jks0502/mcwave/enclosure/README.md

# 富哥方案 · 桌面外壳 V3

按用户确认，将转接板放在屏幕背后现有空间，取消 V2 的独立后仓。总深度由约 77.75 缩至 68.25 mm，减少 9.5 mm。a∥d、后倾12°、左侧29×14mm充电缺口保留。

## 打印文件

print-package-v3.zip 包含以下三个 STL 和打印说明.txt。每件一份，单位 mm，1:1，不缩放。

| 文件 | 零件 | 打印姿态外形 mm |
|---|---|---|
| front.stl | 前框 | 105 × 90.5 × 2.4 |
| body.stl | 后壳底座 | 105 × 65.9 × 94.52 |
| lid.stl | 可拆底盖、限位条 | 99.6 × 56.9 × 9 |

装配外形约105×68.25×95.02mm（宽×深×高）。使用V3整套文件，底座和底盖不可混用V2。
前框和底盖平放，后壳底口朝下需可拆支撑；从底口清理。材料、层高、支撑、首层补偿请商家按设备确定。所有屏座与排线通道去毛刺。

## 本次修改

- 转接板的容量参考为沿屏面的36×30mm、厚4mm，随屏幕倾斜放在屏背空间。该值是设计容量，尚无转接板实测尺寸。
- 屏幕前框和玻璃定位沿用V2；前框STL与V2几何相同。
- 组件 d=97沿左右，e=34沿前后，f=38竖直；相对V2后移2mm，为屏背薄板留余量。
- 组件下方3mm安装高度、平顶净空约2.8mm保留。
- 取消转接板后仓，组件后侧仅留7.5mm用于螺丝柱及装配。后螺丝柱外径6mm，后限位条避让螺丝柱。
- 充电缺口随组件位置平移，仍在左侧且沿e的中央，沿前后宽29mm，从外部底边向上14mm。插头伸入内部时要考虑3mm底盖占用。
- 转接板和屏幕、驱动板之间分两段预留走线，实际线长、插头方向和柔性排线的弯曲仍需试装。

## 装配

1. 清理支撑、毛刺，先不装前框和底盖。
2. 屏幕玻璃91×76.5mm从前面放进后壳浅座，FPC穿下方通道。用户屏厚估计0.95～1.0mm，模型检查按1.2mm参考。薄软垫仅放在非显示边缘，按实际厚度调整，不硬夹玻璃。
3. 四颗3×8mm盘头塑料自攻螺丝轻锁前框。
4. 蓝色转接板随屏面倾斜布置在屏背空余区域，采用绝缘软垫/胶固定在后壳内表面，不让它顶压玻璃。连接屏幕FPC，留出接口和排线余量。
5. 电池、电源和驱动板保持现有组合，在底盖上横放，97mm长边平行屏幕宽边，充电口朝左。用绝缘软垫在可靠支撑面固定，3mm为预留安装高度，避开PCB元件焊点。
6. 延长线由转接板通往组件，按内部空隙自然弯曲收纳。装底盖前用实际Type-C线试插开口，确认板件和线缆均不受挤压。
7. 底盖及组件从下方放入，四颗3×10mm沉头塑料自攻螺丝固定。底孔2.5mm、通孔3.4mm，打印商家需确认螺丝适配。
8. 可贴8mm脚垫四个。底盖用于装配和检修，无独立电池仓盖；检修前断电并释放排线余量。

## CAD 与验证

desktop-enclosure-v3.FCStd 为三个独立实体，装配姿态。尺寸修改使用 design-parameters.json 和 build_case.py 重新生成，Dimensions表仅为尺寸记录。
cad-preview.png 从实际CAD网格渲染，棕色为屏背转接板容量、绿色为组件包络、蓝色为两段走线预留。

已通过深层BOP自交、单一有效实体、零件及参考玻璃/组件无碰撞、屏背转接容量无碰撞、两段走线空隙、玻璃前装、组件/底盖底装、玻璃边缘限位、a∥d实际包络方向、左侧缺口，以及STL封闭和重新导入尺寸体积检查。结果见 verification.json。

尚未打印试装。真实转接板与线缆未测量，屏厚不准确，打印误差与充电插头净空也需实物验证。
