jks0502/mcwave/enclosure/打印说明.txt

富哥方案桌面外壳 V3 - 屏背转接板紧凑版
转接板放屏幕后，取消独立后仓；a与d平行，Type-C仍在左侧。
装配约105 x68.25 x95.02mm。使用V3整套三个STL，底座底盖不要混用V2。
单位mm，1:1，禁止自动缩放。三个零件各打印一件：
front.stl：前框105 x90.5 x2.4mm，平放。
body.stl：后壳底座105 x65.9 x94.52mm，需可拆支撑，从底口清理。
lid.stl：底盖99.6 x56.9 x9mm，底面朝下。
STL已分别放在Z=0。
材料、层高、支撑和首层补偿按商家设备确定；底盖每侧装配间隙0.3mm。
屏座、孔和排线通道去毛刺，玻璃只在非显示边缘软垫支撑，不硬压。
前框配3x8mm盘头塑料自攻4颗，底盖配3x10mm沉头塑料自攻4颗。
底孔2.5mm、通孔3.4mm，请确认螺丝适配。
CAD和STL检查通过，尚未打印试装；转接板、线缆及实际充电插头需试装。
