jks0502/mcwave/enclosure/cad-preview.png

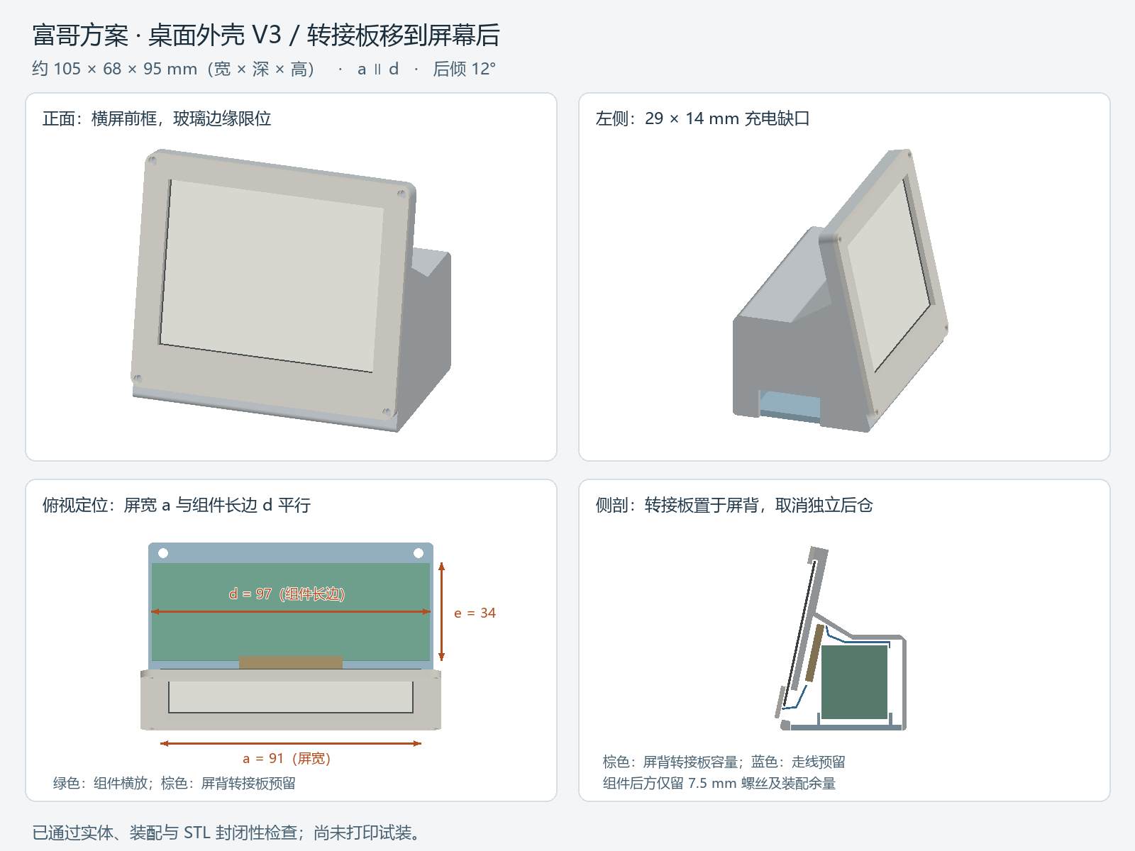
enclosure/cad-preview.png
