jks0502/mcwave/enclosure/body.stl

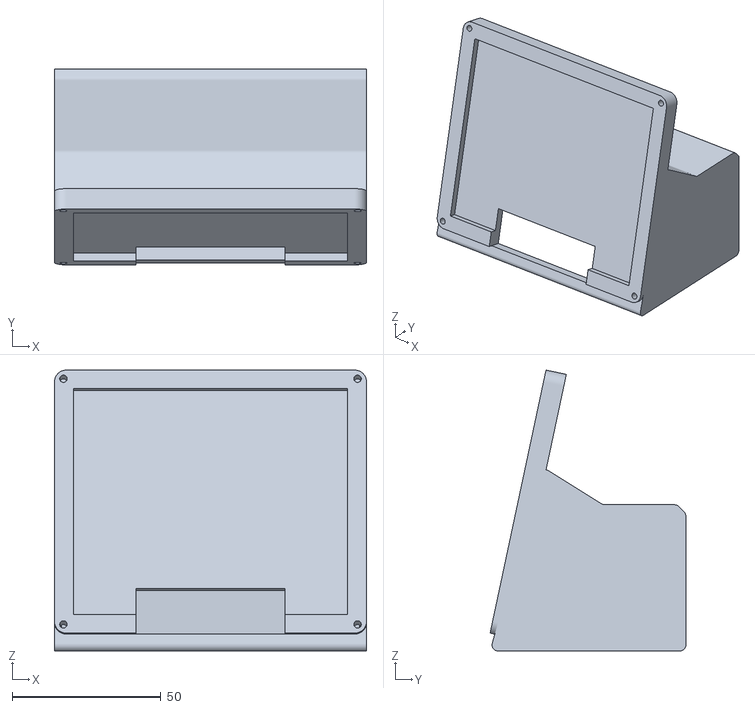
[picture p2: CAD file, 2026-11-02]
enclosure/body.stl
105.0 x 65.9 x 94.5
