jks0502/mcwave/enclosure/front.stl

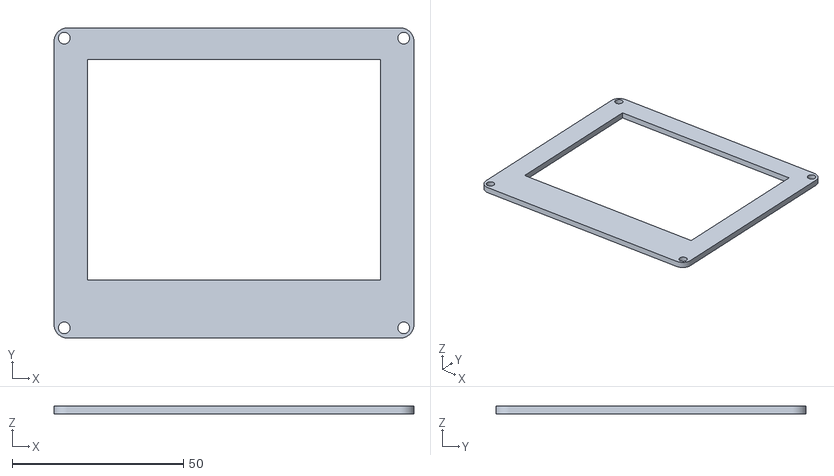
[picture p3: CAD file, 2026-11-02]
enclosure/front.stl
105.0 x 90.5 x 2.40
