jks0502/mcwave/enclosure/lid.stl

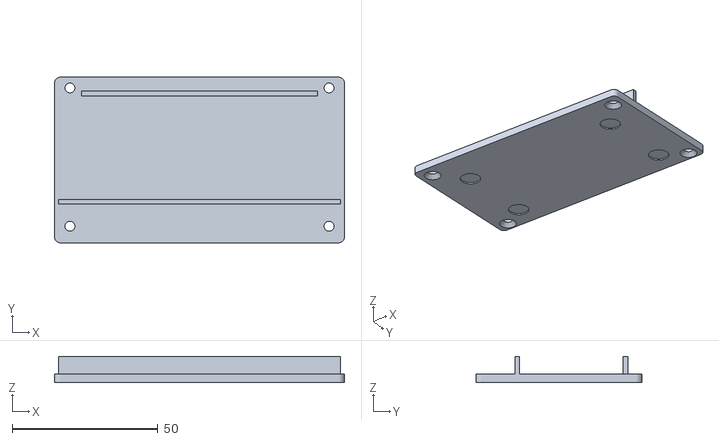
[picture p4: CAD file, 2026-11-02]
enclosure/lid.stl
99.6 x 56.9 x 9.00
