jks0502/mcwave/docs/FIRMWARE_HISTORY.md

# mcwave 固件版本更新历史

版本号规则（2026-10-21 起）：`大.中.小`——大＝改分区或只能有线升级；中＝新功能；小＝修复或小调整。设备上报字符串带 `V`（如 `V7.1.0`）。10-21 之前的 `V1.0–V5.4` 是旧写法，不重新编号。

## 第一阶段：天气 + 赛事摆件（V1.0–V4.8，2026-10-03 → 10-19）

| 版本 | 干嘛的 |
| --- | --- |
| V1.0–V2.3 | 天气桌面小钟：联网取天气，画天气页和形象图 |
| V2.4 | 每分钟独立随机换一张形象图 |
| V3.0 | 新增紧凑两列赛事页，每页 8 场，今日在前；BOOT 短按切页、长按翻页 |
| V3.1 | 改用国内公开数据源直连（中国天气网、腾讯体育、5E），不再依赖境外聚合接口，修热点下加载失败 |
| V3.2 | 天气失败时保留旧数据；赛事每分钟查询 |
| V3.3 | 修赛事解析因 40KB 临时缓冲分配失败而停在旧时间 |
| V3.4 | 修网络读取占满 CPU 触发看门狗重启；天气赛事断电缓存 |
| V3.5 | SEU 校园网网页自动认证、每分钟检查、失效重登 |
| V3.6 | 校园网名称改为区分大小写的 `SEU-WLAN`，启动扫描日志 |
| V3.7 | 针对 HINK 屏改成"全刷后休眠"，自动刷屏至少间隔 1 分钟 |
| V3.8–V3.9 | 赛事去重：同场比赛不同 ID、主客队互换、各项目统一规则 |
| V3.10 | 下次降雨时点 + 同小时概率（中央气象台 + 中国天气通，免 Token） |
| V3.11 | 降雨时间改成"今天约 18 时 / 明天约 02 时 / 4 天后"，按北京时间日历算 |
| V4.0 | 接入个人网站：网页远程选天气 / 赛事、翻页；设备主动 HTTPS，适配校园网 |
| V4.1 | 赛事筛选与补足：关注比赛全保留，不足 16 / 8 场按热门球队补充 |
| V4.2 | 天气页文字统一 13px Noto Sans SC，预报行对齐 |
| V4.3 | HTTP 正文共用固定 1KB 接收缓冲，省内存 |
| V4.4 | 天气与赛事 JSON 共用工作区，修 DNS 缓存清理缺锁的启动断言 |
| V4.5 | 赛事 JSON 一次分配直接生成 |
| V4.6 | 语录 10000 句缩到 100 句，程序瘦约 588KB |
| V4.7 | 字形表二分查找，布局不变 |
| V4.8 | 赛事按赛况调整查询间隔（有比赛进行每分钟，否则半小时） |

## 第二阶段：云相册与无线升级（V5.0–5.6，10-19 → 10-21）

| 版本 | 干嘛的 |
| --- | --- |
| V5.0 | 私有云相册：上传自动转点阵、远程选图、顺序 / 随机轮播、最近 20 张离线缓存 |
| V5.4 | 修校园网 TLS 信任加载与认证恢复；旧 huge_app 单分区的最后一版 |
| 5.5.0 | 素材压缩，改成两个 1.75MiB OTA 分区，支持无线升级（改分区，需有线安装） |
| 5.6.0 | 仅版本号，用来实测无线更新（下载约 24 分钟，成功） |
| 5.6.1 | 屏幕无响应 / 松动不再让整板停机 |
| 5.6.2 | 网络忙时不重绘；缺图缺字不上屏（修动画消失） |

## 第三阶段：变成"送给她的礼物"（6.0–6.3，10-21 → 10-22）

| 版本 | 干嘛的 |
| --- | --- |
| 6.0.0 | 去掉赛事页，新增**双人心情页**（左 jks / 右 momosaysay） |
| 6.0.1 | 同步之间保持网站连接 |
| 6.0.2 | 每个 HTTP 正文最多 2 分钟；开机连信号最强的 AP |
| 6.1.0 | 天气页配图换成水豚，配 100 句语录 |
| 6.1.1 | 换成真正的水豚形象（32 张） |
| 6.1.2 | 网站请求超时调整；查天气、下载前先关保持连接，释放内存 |
| 6.1.3 | 非相册模式相册缓存检查改 10 分钟一次 |
| 6.1.4 | 保持的连接被服务器关掉时立即重试 |
| 6.1.5 | 传输时关闭 Wi-Fi 省电，白天失败率从 11% 降到 4.3% |
| 6.2.0 | 心情页同步更勤，新心情优先刷屏 |
| 6.3.0 | **屏幕画面镜像**：刷屏成功后上传整屏画面，最低优先级、每分钟最多一次 |

## 第四阶段：让它不会坏（6.3.1–6.5.1，10-25 → 10-29）

| 版本 | 干嘛的 |
| --- | --- |
| 6.3.1 | loopTask 600 秒任务看门狗；60 分钟无同步成功自动重启；开机复位原因日志 |
| 6.3.2 | 欠压（约 2.70V）硬复位；RTC 看门狗 12 分钟；复位原因计数写入 NVS |
| 6.4.0 | 接入 NJIT 校园网认证路径 |
| 6.4.1 | DNS 多地址轮转、成功优先，减少"同一个地址连不上" |
| 6.5.0 | NJIT > 普通 Wi-Fi 优先级；WPA3 / 可选 PMF 兼容；认证拒绝退避 |
| 6.5.1 | 网络状态与天气状态解耦；天气缺失 / 9999 时保留有效温湿度和缓存；双网最终版 |

## 第五阶段：不依赖 Wi-Fi，然后收官（7.0–7.1，10-31 → 11-01）

| 版本 | 干嘛的 |
| --- | --- |
| 7.0.0 | **USB 网关**：插到 Windows 电脑，由电脑提供时间和网络；固件自己做 TLS；串口按偏移确认重传；没插电脑自动退回 Wi-Fi |
| 7.0.1 | 仅版本号，验证 OTA 经 USB 网关完整安装（下载 1.4MB 约 18 分钟，成功） |
| 7.0.2 | 修两个遗留问题：同步抢锁时机；时间保存 NVS 失败的重试 |
| **7.1.0** | **最终版**：固件板型绑定，OTA 校验板型标记，拒绝错板固件；2026-11-01 经 USB 网关 OTA 安装到位 |
