jks0502/mcwave/firmware/CampusCertificates.h

// Mozilla CA export: https://curl.se/ca/cacert.pem
// PEM SHA256: a41b5d356aea97a529fe27e0f7316d2f9d946d75927476cf9cf1b90637d00505
// ESP-IDF 5.5 indexed offsets; converted from the bundled Espressif generator.
#pragma once
#include <stdint.h>
// Inline variable shares one flash copy across campus and domestic requests.
inline const uint8_t kCampusCaBundle[]={
  0xe4,0x01,0x00,0x00,0x48,0x04,0x00,0x00,0xad,0x05,0x00,0x00,0x12,0x08,0x00,0x00,0xac,0x08,0x00,0x00,0x63,0x09,0x00,0x00,
  0xca,0x0b,0x00,0x00,0x33,0x0e,0x00,0x00,0xee,0x0e,0x00,0x00,0x57,0x11,0x00,0x00,0xc4,0x13,0x00,0x00,0x32,0x16,0x00,0x00,
  0xa1,0x18,0x00,0x00,0x11,0x1b,0x00,0x00,0xd5,0x1b,0x00,0x00,0x47,0x1e,0x00,0x00,0xba,0x20,0x00,0x00,0x7f,0x21,0x00,0x00,
  0xf2,0x23,0x00,0x00,0xb7,0x24,0x00,0x00,0x7c,0x25,0x00,0x00,0xf0,0x27,0x00,0x00,0x64,0x2a,0x00,0x00,0xd8,0x2c,0x00,0x00,
  0x9e,0x2d,0x00,0x00,0x12,0x30,0x00,0x00,0xd8,0x30,0x00,0x00,0x4c,0x33,0x00,0x00,0x14,0x34,0x00,0x00,0x8a,0x36,0x00,0x00,
  0x53,0x37,0x00,0x00,0xca,0x39,0x00,0x00,0x41,0x3c,0x00,0x00,0xb9,0x3d,0x00,0x00,0x31,0x40,0x00,0x00,0xfb,0x40,0x00,0x00,
  0x73,0x43,0x00,0x00,0xec,0x44,0x00,0x00,0x65,0x47,0x00,0x00,0xde,0x49,0x00,0x00,0x58,0x4c,0x00,0x00,0xd2,0x4e,0x00,0x00,
  0x9e,0x4f,0x00,0x00,0x6a,0x50,0x00,0x00,0xe4,0x52,0x00,0x00,0x5f,0x55,0x00,0x00,0xda,0x57,0x00,0x00,0xa7,0x58,0x00,0x00,
  0x23,0x5a,0x00,0x00,0x9f,0x5c,0x00,0x00,0x50,0x5d,0x00,0x00,0x1e,0x5e,0x00,0x00,0x9b,0x60,0x00,0x00,0x18,0x63,0x00,0x00,
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
  0x6f,0x44,0xe5,0x1b,0x41,0xcf,0xe1,0x86,0xa7,0xca,0xd0,0x6a,0x9f,0xbc,0x4c,0x8d,0x06,0x33,0x5a,0xa2,0x85,0xe5,0x90,0x35,
  0xa0,0x62,0x5c,0x16,0x4e,0xf0,0xe3,0xa2,0xfa,0x03,0x1a,0xb4,0x2c,0x71,0xb3,0x58,0x2c,0xde,0x7b,0x0b,0xdb,0x1a,0x0f,0xeb,
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
};
