jks0502/mcwave/firmware/TlsTrust.h

#pragma once
#include <cstring>
#include "CampusCertificates.h"
#include "CooperativeSecureClient.h"
// Same Mozilla roots as the bundle. A direct CA chain lets mbedTLS terminate
// at the trusted G2/R1/R4 keys instead of chasing obsolete cross-signing parents.
// Cloudflare free Universal SSL may renew from Google Trust Services, Let's
// Encrypt or SSL.com, so the site trusts GTS R1/R4, ISRG X1/X2 and SSL.com ECC
// roots. Without OTA a renewal from an untrusted CA would strand every board.
inline constexpr char kDigiCertG2[]=R"PEM(-----BEGIN CERTIFICATE-----
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
MrY=
-----END CERTIFICATE-----
)PEM";
inline constexpr char kCloudflareRoots[]=R"PEM(-----BEGIN CERTIFICATE-----
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
bP6MvPJwNQzcmRk13NfIRmPVNnGuV/u3gm3c
-----END CERTIFICATE-----
-----BEGIN CERTIFICATE-----
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
-----END CERTIFICATE-----
-----BEGIN CERTIFICATE-----
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
m+kXQ99b21/+jh5Xos1AnX5iItreGCc=
-----END CERTIFICATE-----
-----BEGIN CERTIFICATE-----
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
/q4AaOeMSQ+2b1tbFfLn
-----END CERTIFICATE-----
-----BEGIN CERTIFICATE-----
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
-----END CERTIFICATE-----
-----BEGIN CERTIFICATE-----
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
-----END CERTIFICATE-----
)PEM";
inline const char *tlsRootForUrl(const char *url) {
  const char *digicert[]={"https://matchweb.sports.qq.com/","https://esports-data.5eplaycdn.com/"};
  for(const char *prefix:digicert)if(!std::strncmp(url,prefix,std::strlen(prefix)))return kDigiCertG2;
  const char *cloud="https://jks0502.xyz/";
  return !std::strncmp(url,cloud,std::strlen(cloud))?kCloudflareRoots:nullptr;
}
inline void configureTlsTrust(CooperativeSecureClient &client,const char *url) {
  if(const char *root=tlsRootForUrl(url))client.setCACert(root);
  else client.setCACertBundle(kCampusCaBundle,sizeof(kCampusCaBundle));
}
