jks0502/mcwave/firmware/DomesticCertificates.h

#pragma once
// CA anchors from host-verified domestic provider TLS chains.
// SHA256: cb3ccbb76031e5e0138f8dd39a23f9de47ffc35e43c1144cea27d46a5ab1cb5f
// SHA256: b10b6f00e609509e8700f6d34687a2bfce38ea05a8fdf1cdc40c3a2a0d0d0e45
// SHA256: d947432abde7b7fa90fc2e6b59101b1280e0e1c7e4e40fa3c6887fff57a7f4cf
// SHA256: 5cc3d78e4e1d5e45547a04e6873e64f90cf9536d1ccc2ef800f355c4c5fd70fd
static const char kDomesticRootCertificates[]=R"CERT(-----BEGIN CERTIFICATE-----
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
MrY=
-----END CERTIFICATE-----
-----BEGIN CERTIFICATE-----
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
-----END CERTIFICATE-----
-----BEGIN CERTIFICATE-----
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
bP6MvPJwNQzcmRk13NfIRmPVNnGuV/u3gm3c
-----END CERTIFICATE-----
-----BEGIN CERTIFICATE-----
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
-----END CERTIFICATE-----
)CERT";
