jks0502/mcwave/firmware/Quotes.h

// Generated and validated by tools/prepare_quotes.py.
#pragma once
#include <stdint.h>
constexpr uint8_t kQuoteCount = 100;
static const char *const kQuotes[kQuoteCount] = {
  "噜噜泡进温泉里，今天也情绪稳定。",
  "噜噜头顶小柚子，慢慢来也很可爱。",
  "噜噜晒着小太阳，记得喝一口水呀。",
  "噜噜趴着发会呆，给自己留点空闲。",
  "噜噜朝你眨眨眼，今天也要吃好饭。",
  "噜噜慢慢嚼青草，好事不用赶时间。",
  "噜噜伸个大懒腰，忙完记得歇一歇。",
  "噜噜窝在草堆里，累了就早点休息。",
  "噜噜顶着小橘子，开心就笑出来吧。",
  "噜噜泡着热水澡，烦恼先放一边去。",
  "噜噜挪到树荫下，风来了就吹一吹。",
  "噜噜和小鸟聊天，朋友都在你身边。",
  "噜噜眯着小眼睛，深呼吸慢慢放松。",
  "噜噜蹭蹭你的手，今天辛苦你啦。",
  "噜噜不慌也不忙，一步一步就很好。",
  "噜噜抱着小西瓜，夏天也要甜甜的。",
  "噜噜晃晃小耳朵，认真听自己的心。",
  "噜噜躺平晒肚皮，偶尔偷懒没关系。",
  "噜噜守着小池塘，安安静静陪着你。",
  "噜噜吃饱打个嗝，好好吃饭最重要。",
  "噜噜打了个哈欠，困了就闭眼一会。",
  "噜噜慢慢往前走，小进步也值得夸。",
  "噜噜给你递橘子，酸酸甜甜分一半。",
  "噜噜坐在门口等，等你回来说说话。",
  "噜噜不和人比较，做自己就已很好。",
  "噜噜在水里漂着，心情也跟着变轻。",
  "噜噜靠着小伙伴，难过时也有依靠。",
  "噜噜悄悄探出头，看看今天的天气。",
  "噜噜抖抖身上水，坏心情也抖掉吧。",
  "噜噜数着小星星，晚上要好好睡觉。",
  "噜噜叼着一片叶，春天的风刚刚好。",
  "噜噜围着小围巾，天冷记得多穿点。",
  "噜噜捧着热奶茶，暖暖手再出门吧。",
  "噜噜坐成一个团，圆圆滚滚很满足。",
  "噜噜慢吞吞起床，早安也可以慢点。",
  "噜噜点点小脑袋，你说的都有道理。",
  "噜噜站着不说话，安静也是一种好。",
  "噜噜给你比个心，今天也被喜欢着。",
  "噜噜望着窗外雨，下雨天适合发呆。",
  "噜噜踩着小水坑，玩一会儿再回家。",
  "噜噜在草地打滚，开心就要大声笑。",
  "噜噜泡完温泉了，整个身体都软软。",
  "噜噜和柚子合影，记录今天的小事。",
  "噜噜啃着小苹果，记得也吃点水果。",
  "噜噜听着流水声，脑袋放空一分钟。",
  "噜噜背着小书包，出门记得带钥匙。",
  "噜噜靠着大石头，休息好了再出发。",
  "噜噜看见你来了，尾巴都想摇一摇。",
  "噜噜不急着回复，慢慢想清楚再说。",
  "噜噜钻进被窝里，今天到这里就好。",
  "噜噜晒干了毛毛，蓬蓬松松很舒服。",
  "噜噜给你留座位，累了就坐下来吧。",
  "噜噜拍拍小肚子，饭后散步走一走。",
  "噜噜望着远方山，目标慢慢会靠近。",
  "噜噜轻轻哼着歌，小小快乐不打烊。",
  "噜噜陪你等公交，等待也可以轻松。",
  "噜噜吹着小泡泡，烦心事飘走啦。",
  "噜噜顶着三橘子，平衡感今天满分。",
  "噜噜躲在荷叶下，雨再大也不怕。",
  "噜噜低头喝口水，你也记得补水哦。",
  "噜噜蹲在角落里，需要安静也正常。",
  "噜噜和鸭子并排，谁先到都没关系。",
  "噜噜收到你的信，开心了一整天。",
  "噜噜把烦恼泡软，再一口一口吃掉。",
  "噜噜摸摸你的头，今天你做得很好。",
  "噜噜在湖边散步，风景值得慢慢看。",
  "噜噜闭上了眼睛，先睡五分钟再说。",
  "噜噜捡到一颗星，送给认真的你。",
  "噜噜慢慢眨眼睛，看久屏幕歇一歇。",
  "噜噜换上新围兜，今天也要好好吃。",
  "噜噜挤进小纸箱，小小空间也安心。",
  "噜噜看着云飘过，变化都会慢慢来。",
  "噜噜和你碰碰鼻，打个招呼说早安。",
  "噜噜嚼着胡萝卜，一口一口很认真。",
  "噜噜不怕走得慢，走得稳才走得远。",
  "噜噜等水烧开了，泡杯热茶歇一歇。",
  "噜噜抱着小枕头，晚安要说得甜甜。",
  "噜噜翻了个身哦，换个角度看看吧。",
  "噜噜认真晒太阳，充好电再去忙。",
  "噜噜站在雨里笑，雨停了会有彩虹。",
  "噜噜给你加个油，难事也能慢慢过。",
  "噜噜趴在你身旁，安静地陪你一会。",
  "噜噜摇摇小脑袋，不开心就说出来。",
  "噜噜在水面画圈，一圈一圈都很圆。",
  "噜噜分你一半草，好东西要一起吃。",
  "噜噜看着你工作，记得伸伸懒腰哦。",
  "噜噜躺在月光下，今晚会有好梦。",
  "噜噜偷吃了橘子，酸得眯起了眼睛。",
  "噜噜慢慢长大了，你也在慢慢变好。",
  "噜噜举起小爪子，今天的你最棒啦。",
  "噜噜和朋友泡澡，一起放松最开心。",
  "噜噜守护着你哦，有事就喊一声吧。",
  "噜噜吃着小饼干，周末要好好放松。",
  "噜噜在路边等你，回家路上慢慢走。",
  "噜噜拿着小雨伞，出门看看天气吧。",
  "噜噜坐着看夕阳，今天也辛苦啦。",
  "噜噜轻轻打呼噜，安心睡个好觉吧。",
  "噜噜笑得眯起眼，你笑起来也好看。",
  "噜噜说情绪稳定，我们一起慢慢来。",
  "噜噜和你说晚安，明天也会是好天。",
};
