jks0502/mcwave/firmware/SportsCertificate.h

#pragma once
// Verified TLS root SHA256: 00beaef280277e38999d3c60b27736e8f21e782c3d4b444ac34d465a7ab287c5
static const char kSportsRootCertificate[]=R"CERT(-----BEGIN CERTIFICATE-----
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
KC6Lmtk=
-----END CERTIFICATE-----
)CERT";
