jks0502/mcwave/firmware/WeatherCertificate.h

#pragma once
// Trusted root from a verified api.open-meteo.com TLS chain.
// SHA256: 96bcec06264976f37460779acf28c5a7cfe8a3c0aae11a8ffcee05c0bddf08c6
static const char kWeatherRootCertificate[] = R"CERT(-----BEGIN CERTIFICATE-----
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
-----END CERTIFICATE-----
)CERT";
