jks0502/mcwave/firmware/CampusSecrets.example.h

#pragma once
// Copy to CampusSecrets.h. Enter your campus credentials locally, then upload.
constexpr bool kCampusEnabled = true;
// SSIDs are case-sensitive; verified on this campus as SEU-WLAN.
constexpr char kCampusSsid[] = "SEU-WLAN";
constexpr char kCampusUsername[] = "";
constexpr char kCampusPassword[] = "";
// false uses the original hotspot settings in Secrets.h.
