jks0502/mcwave/firmware/DeviceIdentity.example.h

#pragma once
// mcwave compatibility transport. The cloud binding determines the identity.
// Copy to DeviceIdentity.h only after registering and binding this physical device.
constexpr char kRemoteUrl[]="https://jks0502.xyz/api/device/sync";
constexpr char kRemoteToken[]=""; // Independent 64-character hex credential.
