jks0502/mcwave/firmware/NjitSecrets.example.h

#pragma once
// Copy to ignored NjitSecrets.h. Select only with build -Defines MCWAVE_NJIT.
// SEU CampusSecrets.h stays independent; edison does not use this profile.
constexpr bool kCampusEnabled = true;
constexpr char kCampusSsid[] = "NJIT";
constexpr char kCampusUsername[] = "";
constexpr char kCampusPassword[] = "";
