jks0502/mcwave/firmware/RemoteSecrets.example.h

#pragma once
constexpr char kRemoteUrl[]="https://jks0502.xyz/api/device/sync";
// Local-only random 64-character hex token, also stored as the Worker DEVICE_TOKEN secret.
constexpr char kRemoteToken[]="";
